jtwaleson/cowboy-bike-remote-ble/(list of files, drawings)

Other design files:
pcb-design/SCH_Cowboy-key_2022-04-16.json
