jtwaleson/cowboy-bike-remote-ble/(commit log)

2022-04-01 add ESP32 code sample
2022-04-06 clean up the code and fix light status
    Now the light will properly toggle instead of doing random things.
    [main.c]
2022-04-16 update and add schematics
    [BOM_Cowboy-key_2022-04-16.csv, SCH_Cowboy-key_2022-04-16.json]
2023-03-19 add measurements of original pcb
2023-03-19 update schematic / pcb design
    [BOM_Cowboy-key_2022-04-16.csv, SCH_Cowboy-key_2022-04-16.json]
